lwinmoe51/EchoEarCopyProj/Interface.kicad_sch

## KiCad design Interface.kicad_sch (2026-01-03, an earlier design)

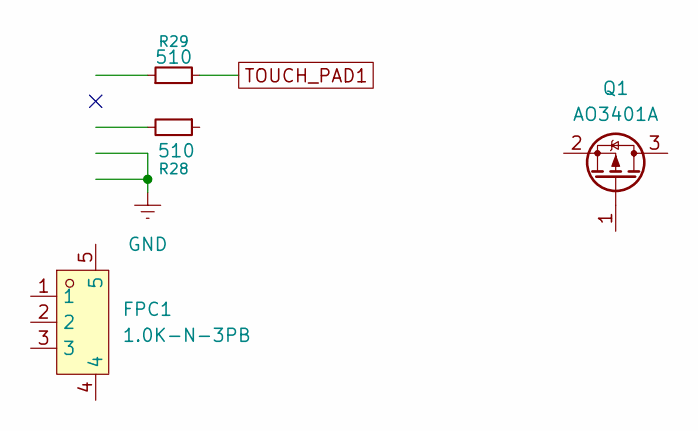
[picture p1: schematic Interface.kicad_sch]

Parts:
FPC1: 1.0K-N-3PB; FPC-SMD_3P-P1.00_HDGC_1.0K-N-3PB; LCSC Part C2915549
Q1: AO3401A; SOT-23
R28, R29: 510

Connections:
TOUCH_PAD1: R29.2
