lwinmoe51/EchoEarCopyProj/MCU.kicad_sch

## KiCad design MCU.kicad_sch (2026-01-03, an earlier design)

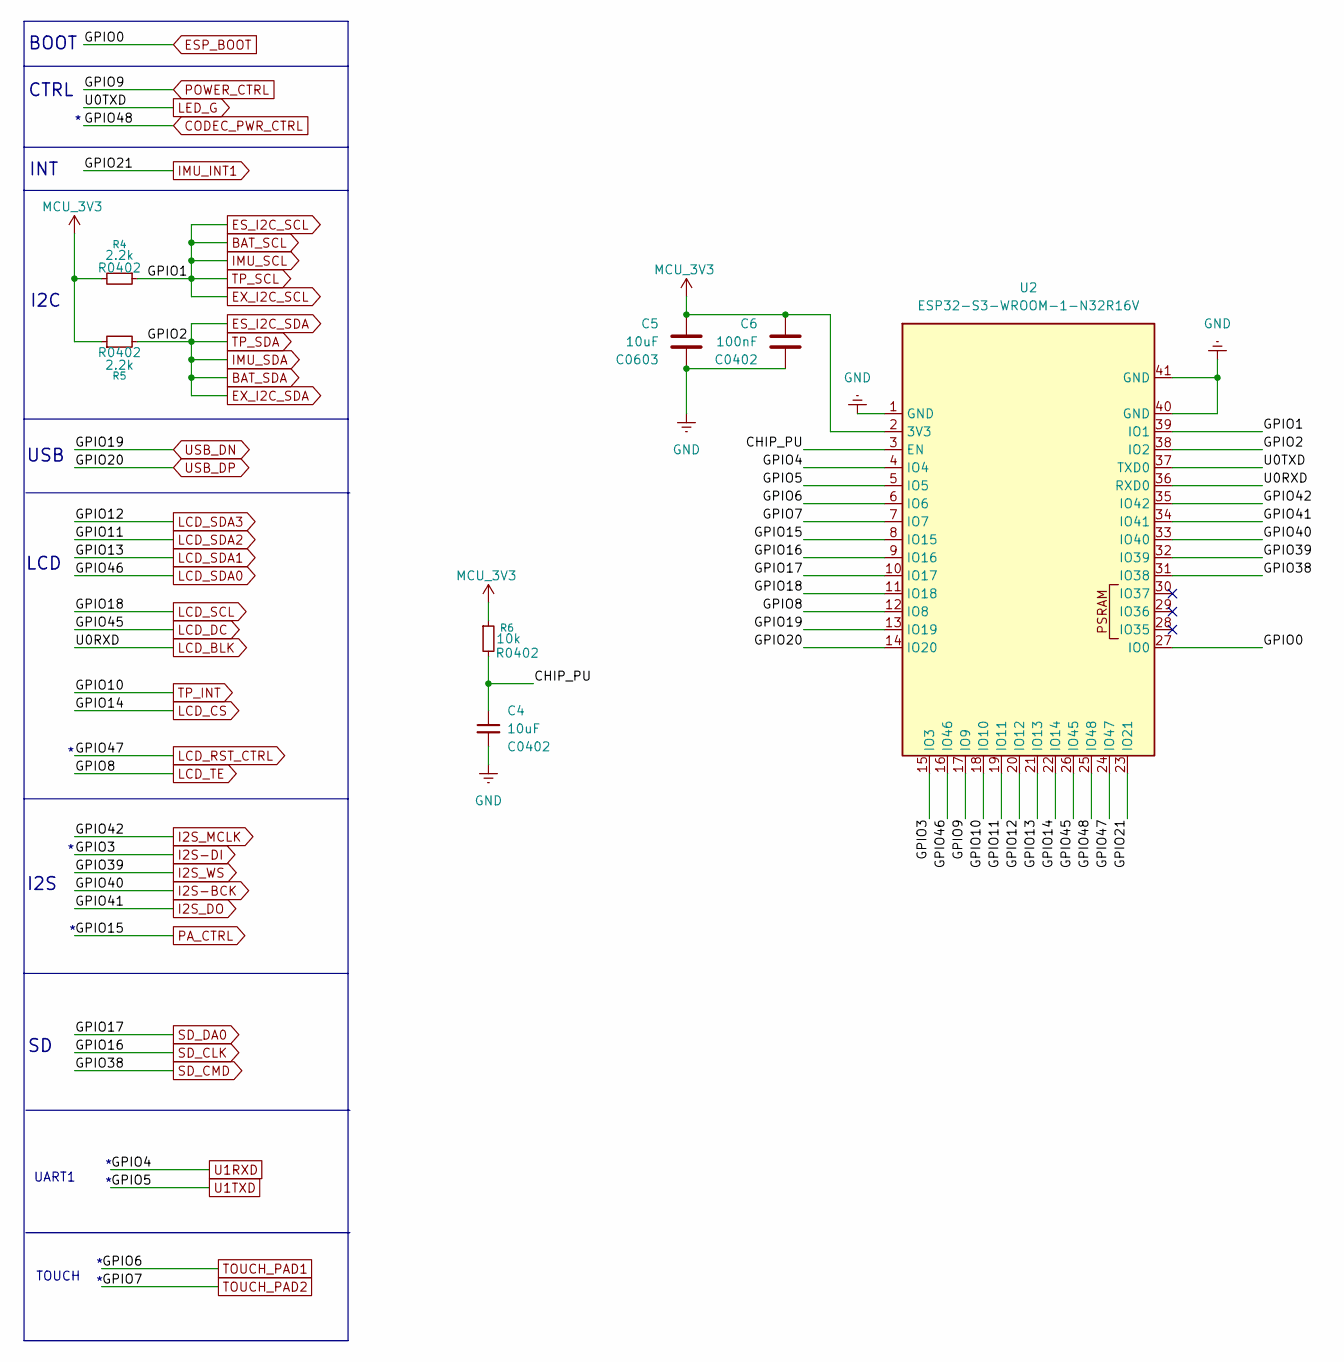
[picture p2: schematic MCU.kicad_sch]

Parts:
C4: 10uF; C0402
C5: 10uF; C0603
C6: 100nF; C0402
R4, R5: 2.2k; R0402
R6: 10k; R0402
U2: ESP32-S3-WROOM-1-N32R16V; ESP32-S3-WROOM-1

Connections:
BAT_SCL: R4.1, U2.39 (IO1)
BAT_SDA: R5.2, U2.38 (IO2)
CHIP_PU: C4.1, R6.2, U2.3 (EN)
CODEC_PWR_CTRL: U2.25 (IO48)
ESP_BOOT: U2.27 (IO0)
GND: C4.2, C5.2, C6.1, U2.1 (GND), U2.40 (GND), U2.41 (GND)
I2S-BCK: U2.33 (IO40)
I2S-DI: U2.15 (IO3)
I2S_DO: U2.34 (IO41)
I2S_MCLK: U2.35 (IO42)
I2S_WS: U2.32 (IO39)
IMU_INT1: U2.23 (IO21)
LCD_BLK: U2.36 (RXD0)
LCD_CS: U2.22 (IO14)
LCD_DC: U2.26 (IO45)
LCD_RST_CTRL: U2.24 (IO47)
LCD_SCL: U2.11 (IO18)
LCD_SDA0: U2.16 (IO46)
LCD_SDA1: U2.21 (IO13)
LCD_SDA2: U2.19 (IO11)
LCD_SDA3: U2.20 (IO12)
LCD_TE: U2.12 (IO8)
LED_G: U2.37 (TXD0)
MCU_3V3: C5.1, C6.2, R4.2, R5.1, R6.1, U2.2 (3V3)
PA_CTRL: U2.8 (IO15)
POWER_CTRL: U2.17 (IO9)
SD_CLK: U2.9 (IO16)
SD_CMD: U2.31 (IO38)
SD_DA0: U2.10 (IO17)
TOUCH_PAD1: U2.6 (IO6)
TOUCH_PAD2: U2.7 (IO7)
TP_INT: U2.18 (IO10)
U1RXD: U2.4 (IO4)
U1TXD: U2.5 (IO5)
USB_DN: U2.13 (IO19)
USB_DP: U2.14 (IO20)

Notes on the sheet:
LCD
CTRL
TOUCH
BOOT
I2S
I2C
UART1
INT
USB
