lwinmoe51/EchoEarCopyProj/P1.kicad_sch

## KiCad design P1.kicad_sch (2026-01-10)

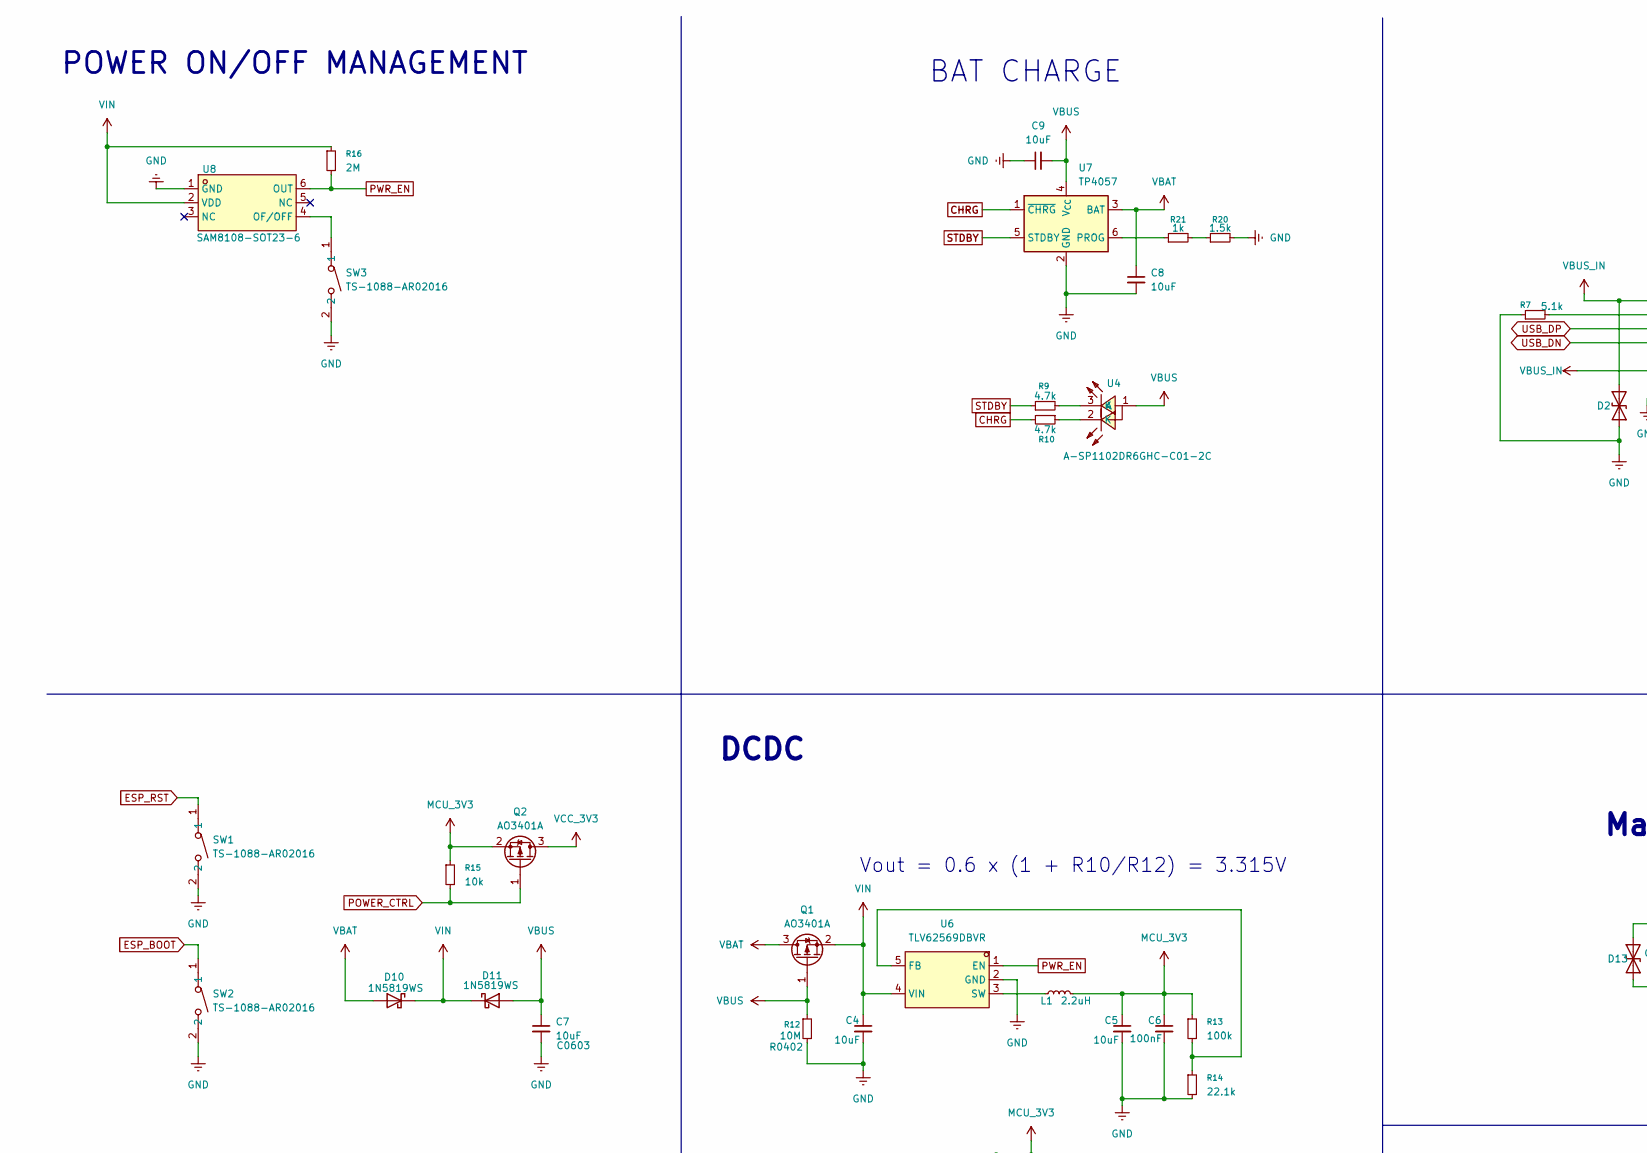
[picture p3: schematic P1.kicad_sch, part in row 1, column 1]

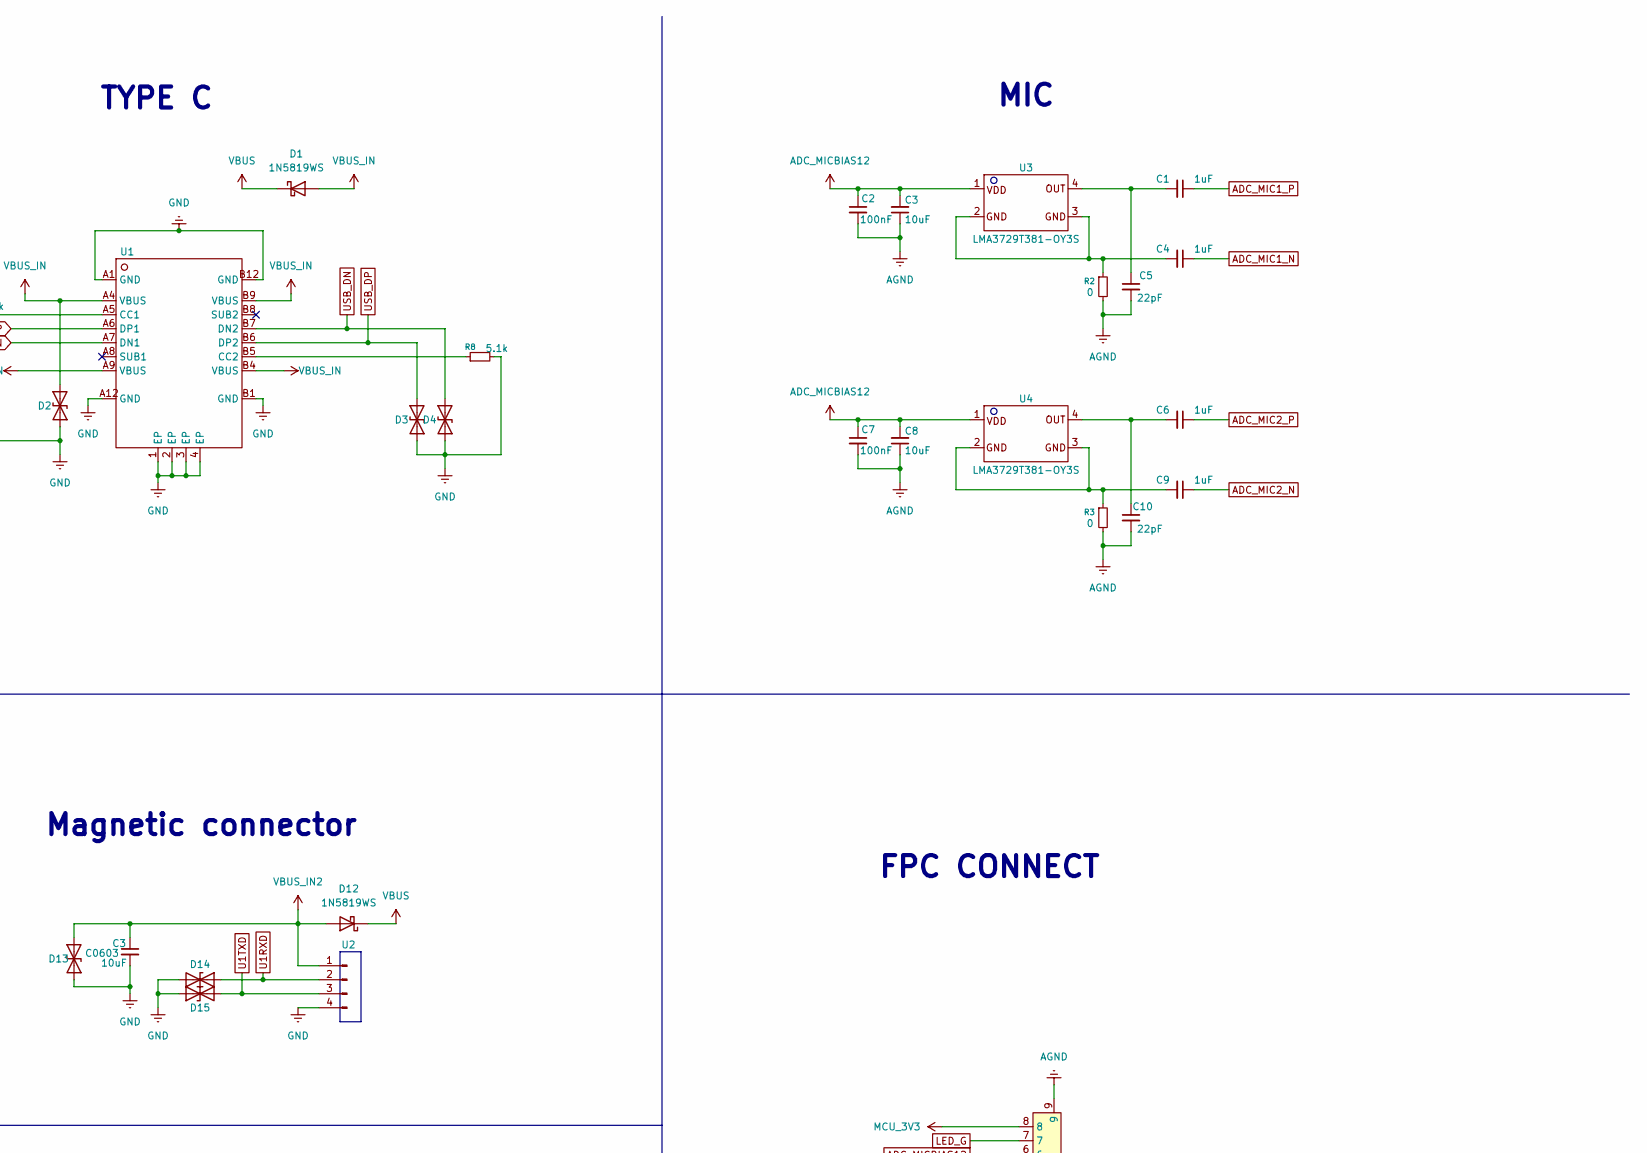
[picture p4: schematic P1.kicad_sch, part in row 1, column 2]

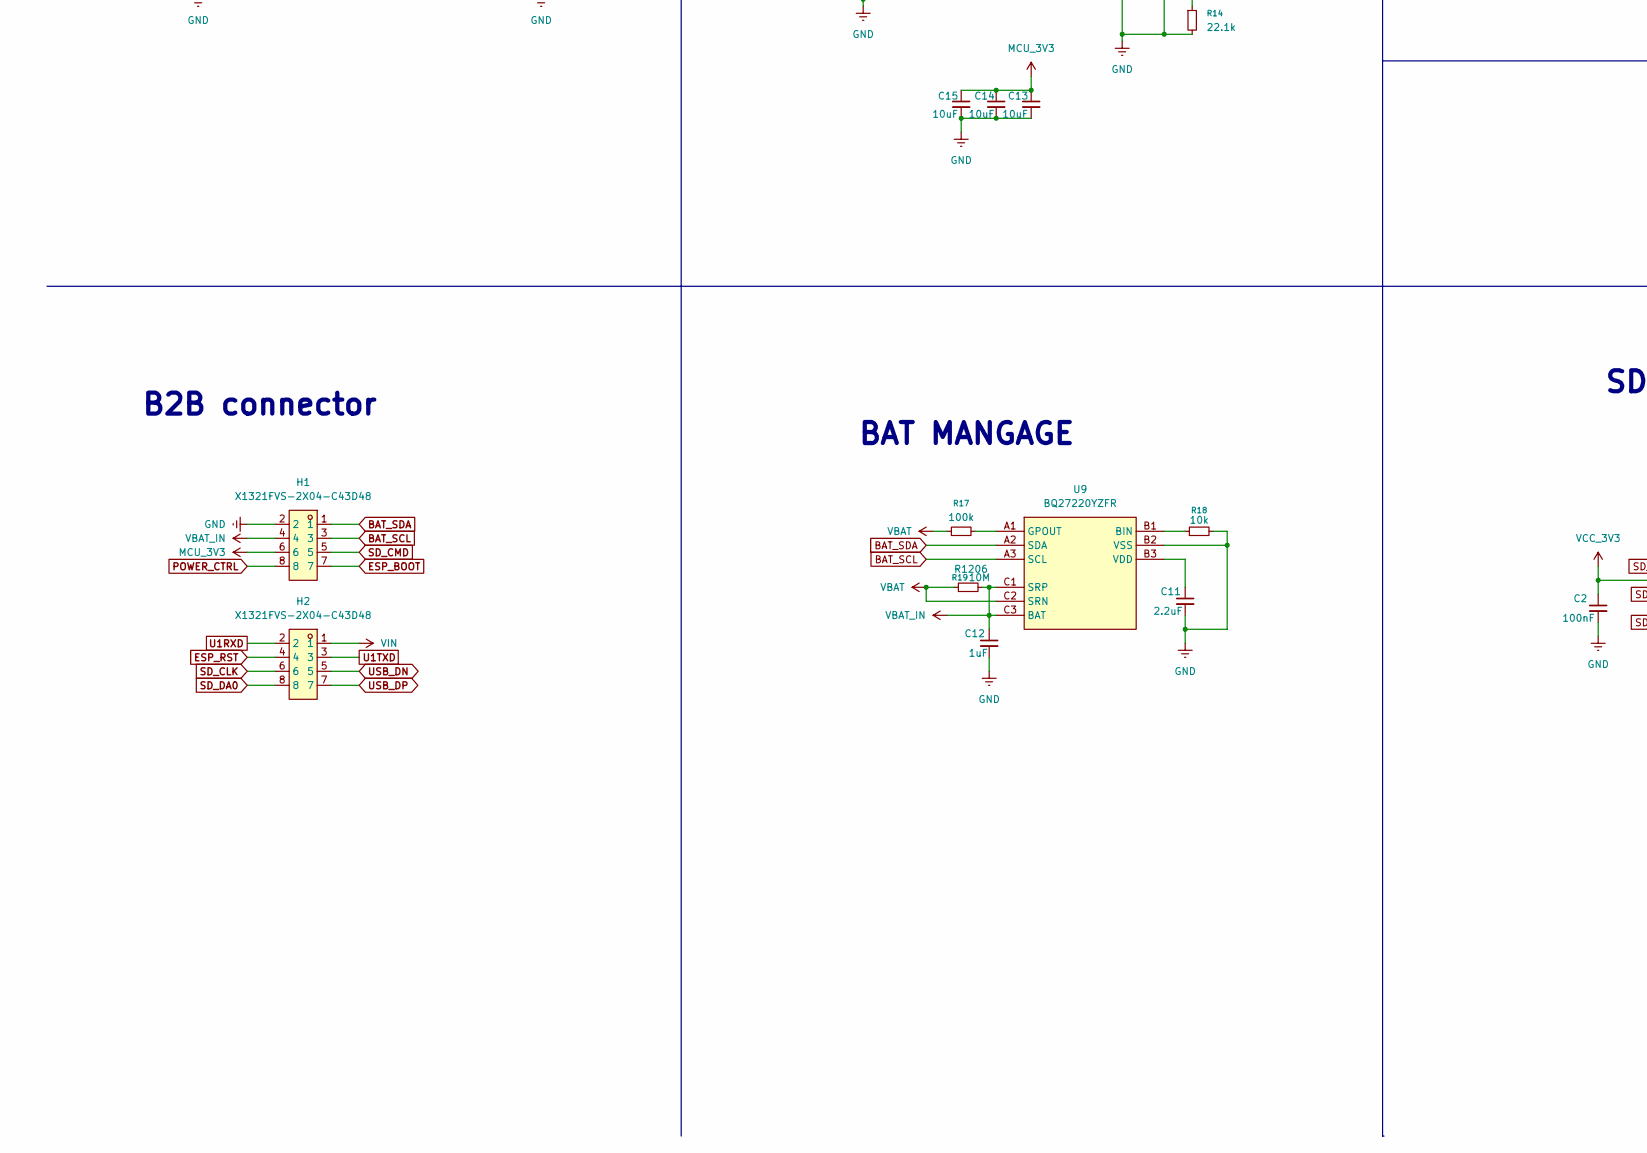
[picture p5: schematic P1.kicad_sch, part in row 2, column 1]

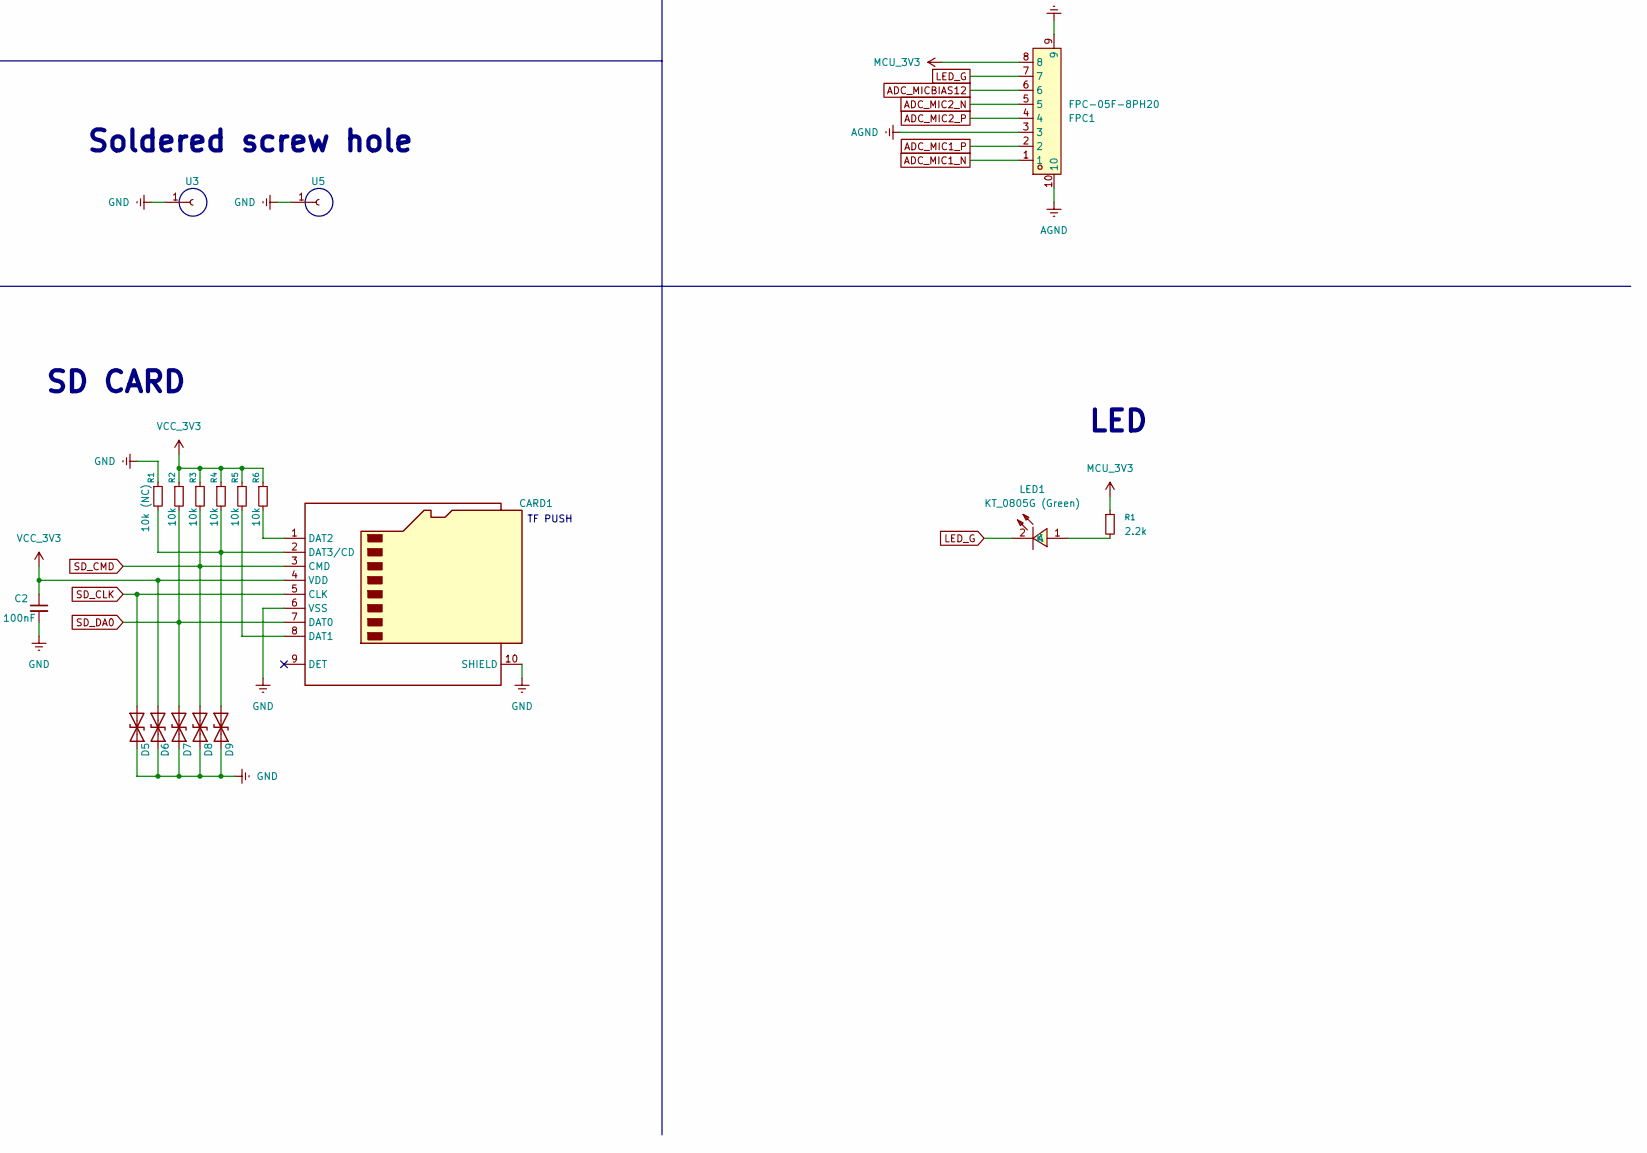
[picture p6: schematic P1.kicad_sch, part in row 2, column 2]

Parts:
C1, C4, C12: 1uF
C2, C6, C7: 100nF
C3: 10uF; C0603
C5, C10: 22pF
C8, C9, C13, C14, C15: 10uF
C11: 2.2uF
CARD1: Micro_SD_Card_Det1
D1, D10, D11, D12: 1N5819WS; D_SOD-323
D2, D3, D4, D5, D6, D7, D8, D9, D13, D14, D15: 1.5KExxCA; D_DO-201AE_P15.24mm_Horizontal
FPC1: FPC-05F-8PH20; FPC-05F-8PH20_FPC-SMD_8P-P0.50_FPC-05F-8PH20; LCSC Part C2856797
H1, H2: X1321FVS-2X04-C43D48; X1321FVS-2x04-C43D48_HDR-SMD_8P-P1.27-V-F-R2-C4-LS4.8; LCSC Part C2684732
L1: 2.2uH
LED1: KT_0805G (Green); KT-0805G_LED0805-R-RD; LCSC Part C2297
Q1, Q2: AO3401A; SOT-23
R1: 10k (NC)
R2, R3, R4, R5, R6, R15, R18: 10k
R7, R8: 5.1k
R9, R10: 4.7k
R12: 10M; R0402
R13, R17: 100k
R14: 22.1k
R16: 2M
R19: 10M; R1206
R20: 1.5k
R21: 1k
SW1, SW2, SW3: TS-1088-AR02016; TS-1088-AR02016_SW-SMD_L3.9-W3.0-P4.45; LCSC Part C720477
U1: (no value)
U2: Conn_01x04_Pin
U3: LMA3729T381-OY3S
U4: A-SP1102DR6GHC-C01-2C; A-SP1102DR6GHC-C01-2C_LED-SMD_3P-L3.0-W1.5_A-SP1102DR6W1D-C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; LCSC Part C19171306
U5: Conn_01x01_Socket
U6: TLV62569DBVR; TLV62569DBVR_SOT-23-5_L3.0-W1.7-P0.95-LS2.8-BR; LCSC Part C141836
U7: TP4057; TSOT-23-6
U8: SAM8108-SOT23-6; SAM8108-SOT-23-6_L2.9-W1.6-P0.95-LS2.8-BL; LCSC Part C9900004427
U9: BQ27220YZFR; DSBGA-9_L1.7-W1.6-R3-C3-P0.50-BL; LCSC Part C528617

Connections:
ADC_MIC1_N: C4.1, FPC1.1
ADC_MIC1_P: C1.1, FPC1.2
ADC_MIC2_N: C9.1, FPC1.5
ADC_MIC2_P: C6.1, FPC1.4
ADC_MICBIAS12: C2.1, C3.2, C7.1, C8.2, FPC1.6, U3.1, U4.1
AGND: C2.2, C3.1, C5.2, C7.2, C8.1, C10.2, FPC1.3, FPC1.9, FPC1.10, R2.2, R3.2
BAT_SCL: H1.3, U9.A3 (SCL)
BAT_SDA: H1.1, U9.A2 (SDA)
CHRG: R10.2, U7.1 (~CHRG)
ESP_BOOT: H1.7, SW2.1
ESP_RST: H2.4, SW1.1
GND: C2.2, C3.2, C4.2, C5.2, C6.2, C7.2, C8.2, C9.1, C11.2, C12.2, C13.2, C14.2, C15.2, CARD1.6 (VSS), CARD1.10 (SHIELD), D2.1 (A1), D3.1 (A1), D4.1 (A1), D5.1 (A1), D6.1 (A1), D7.1 (A1), D8.1 (A1), D9.1 (A1), D13.1 (A1), D14.1 (A1), D15.1 (A1), H1.2, R1.1, R7.1, R8.2, R12.2, R14.2, R18.2, R20.2, SW1.2, SW2.2, SW3.2, U1.1 (EP), U1.2 (EP), U1.3 (EP), U1.4 (EP), U1.A1 (GND), U1.A12 (GND), U1.B1 (GND), U1.B12 (GND), U2.4, U3.1, U5.1, U6.2 (GND), U7.2 (GND), U8.1 (GND), U9.B2 (VSS)
LED_G: FPC1.7, LED1.2 (K)
MCU_3V3: C5.1, C6.1, C13.1, C14.1, C15.1, FPC1.8, H1.6, L1.2, Q2.2 (S), R1.1, R13.1, R15.1
unnamed: C1.2, C5.1, U3.4
unnamed: C4.2, R2.1, U3.2, U3.3
unnamed: C9.2, R3.1, U4.2, U4.3
unnamed: C6.2, C10.1, U4.4
unnamed: C11.1, U9.B3 (VDD)
unnamed: CARD1.1 (DAT2), R6.2
unnamed: CARD1.2 (DAT3/CD), D9.2 (A2), R1.2, R4.2
unnamed: CARD1.8 (DAT1), R5.2
unnamed: L1.1, U6.3 (SW)
unnamed: LED1.1 (A), R1.2
unnamed: R7.2, U1.A5 (CC1)
unnamed: R8.1, U1.B5 (CC2)
unnamed: R9.2, U4.3
unnamed: R10.1, U4.2
unnamed: R13.2, R14.1, U6.5 (FB)
unnamed: R17.2, U9.A1 (GPOUT)
unnamed: R18.1, U9.B1 (BIN)
unnamed: R20.1, R21.2
unnamed: R21.1, U7.6 (PROG)
unnamed: SW3.1, U8.4 (OF/OFF)
POWER_CTRL: H1.8, Q2.1 (G), R15.2
PWR_EN: R16.2, U6.1 (EN), U8.6 (OUT)
SD_CLK: CARD1.5 (CLK), D5.2 (A2), H2.6
SD_CMD: CARD1.3 (CMD), D8.2 (A2), H1.5, R3.2
SD_DA0: CARD1.7 (DAT0), D7.2 (A2), H2.8, R2.2
STDBY: R9.1, U7.5 (STDBY)
U1RXD: D14.2 (A2), H2.2, U2.2
U1TXD: D15.2 (A2), H2.3, U2.3
USB_DN: D4.2 (A2), H2.5, U1.A7 (DN1), U1.B7 (DN2)
USB_DP: D3.2 (A2), H2.7, U1.A6 (DP1), U1.B6 (DP2)
VBAT: C8.1, D10.2 (A), Q1.3 (D), R17.1, R19.1, U7.3 (BAT), U9.C2 (SRN)
VBAT_IN: C12.1, H1.4, R19.2, U9.C1 (SRP), U9.C3 (BAT)
VBUS: C7.1, C9.2, D1.1 (K), D11.2 (A), D12.1 (K), Q1.1 (G), R12.1, U4.1, U7.4 (V_{CC})
VBUS_IN: D1.2 (A), D2.2 (A2), U1.A4 (VBUS), U1.A9 (VBUS), U1.B4 (VBUS), U1.B9 (VBUS)
VBUS_IN2: C3.1, D12.2 (A), D13.2 (A2), U2.1
VCC_3V3: C2.1, CARD1.4 (VDD), D6.2 (A2), Q2.3 (D), R2.1, R3.1, R4.1, R5.1, R6.1
VIN: C4.1, D10.1 (K), D11.1 (K), H2.1, Q1.2 (S), R16.1, U6.4 (VIN), U8.2 (VDD)

Notes on the sheet:
B2B connector
TYPE C
MIC
SD CARD
DCDC
Soldered screw hole
BAT MANGAGE
Vout = 0.6 x (1 + R10/R12) = 3.315V
TF PUSH
POWER ON/OFF MANAGEMENT
BAT CHARGE
LED
FPC CONNECT
Magnetic connector
