lwinmoe51/EchoEarCopyProj/codec.kicad_sch

## KiCad design codec.kicad_sch (2026-01-08)

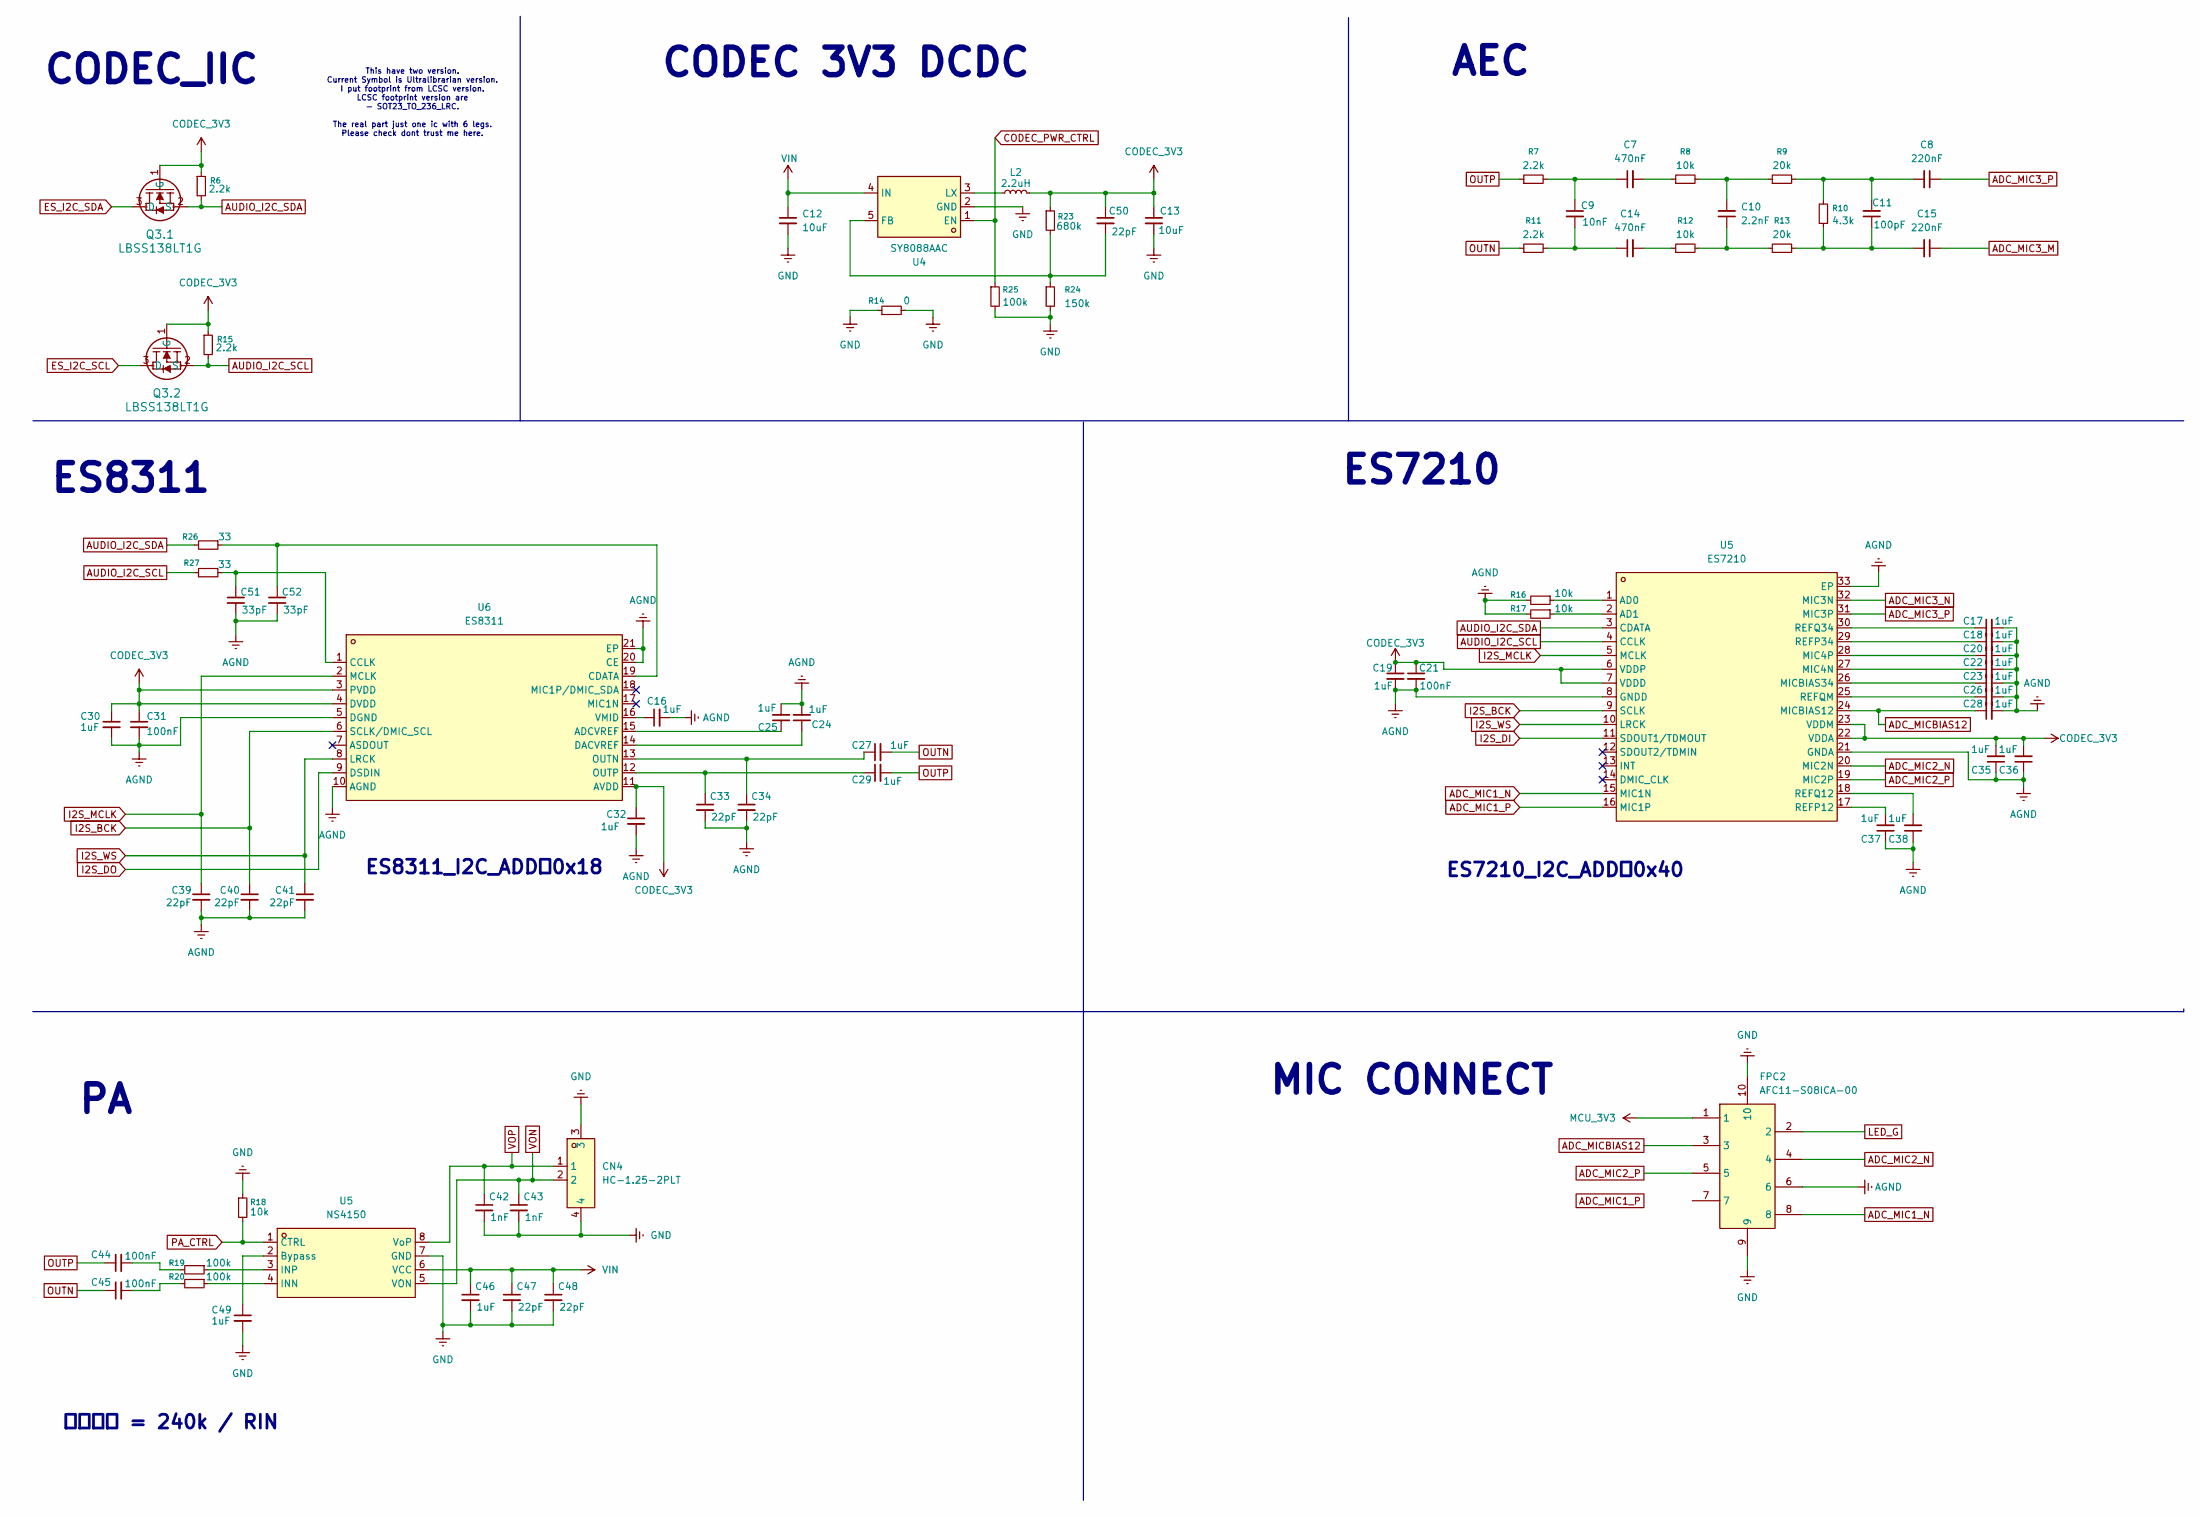
[picture p7: schematic codec.kicad_sch]

Parts:
C7, C14: 470nF
C8, C15: 220nF
C9: 10nF
C10: 2.2nF
C11: 100pF
C12, C13: 10uF
C16, C17, C18, C19, C20, C22, C23, C24, C25, C26, C27, C28, C29, C30, C32, C35, C36, C37, C38, C46, C49: 1uF
C21, C31, C44, C45: 100nF
C33, C34, C39, C40, C41, C47, C48, C50: 22pF
C42, C43: 1nF
C51, C52: 33pF
CN4: HC-1.25-2PLT; CONN-SMD_4P-P1.25_HCTL_HC-1.25-4PLT; LCSC Part C2845388
FPC2: AFC11-S08ICA-00; CONN-TH-8P_AFC11-S08ICA-00; LCSC Part C262497
L2: 2.2uH
Q3.1, Q3.2: LBSS138LT1G; LBSS138LT1G_SC-88-6_L2.0-W1.3-P0.65-LS2.1-BL
R6, R7, R11, R15: 2.2k
R8, R12, R16, R17, R18: 10k
R9, R13: 20k
R10: 4.3k
R14: 0
R19, R20, R25: 100k
R23: 680k
R24: 150k
R26, R27: 33
U4: SY8088AAC; SY8088AAC_SOT-23-5_L3.0-W1.7-P0.95-LS2.8-BR; LCSC Part C79313
U5: ES7210; ES7210_QFN-32_L4.0-W4.0-P0.40-BL-EP2.7; LCSC Part C365743
U6: ES8311; ES8311_WQFN-20_L3.0-W3.0-P0.40-BL-EP1.7; LCSC Part C962342

Connections:
ADC_MIC1_N: FPC2.8, U5.15 (MIC1N)
ADC_MIC1_P: U5.16 (MIC1P)
ADC_MIC2_N: FPC2.4, U5.20 (MIC2N)
ADC_MIC2_P: FPC2.5, U5.19 (MIC2P)
ADC_MIC3_M: C15.1
ADC_MIC3_N: U5.32 (MIC3N)
ADC_MIC3_P: C8.1, U5.31 (MIC3P)
ADC_MICBIAS12: C28.1, FPC2.3, U5.24 (MICBIAS12)
AGND: C16.2, C17.2, C18.2, C19.2, C20.2, C21.2, C22.2, C23.2, C24.2, C25.2, C26.2, C28.2, C30.2, C31.2, C32.2, C33.2, C34.2, C35.1, C36.1, C37.1, C38.1, C39.2, C40.2, C41.2, C51.2, C52.2, FPC2.6, R16.2, R17.2, U5.8 (VoP), U5.21 (GNDA), U5.33 (EP), U6.5 (DGND), U6.10 (AGND), U6.20 (CE), U6.21 (EP)
AUDIO_I2C_SCL: Q3.2.2 (S), R15.2, R27.1, U5.4 (INN)
AUDIO_I2C_SDA: Q3.1.2 (S), R6.2, R26.2, U5.3 (INP)
CODEC_3V3: C13.1, C19.1, C21.1, C30.1, C31.1, C32.1, C35.2, C36.2, C50.1, L2.2, Q3.1.1 (G), Q3.2.1 (G), R6.1, R15.1, R23.1, U5.6 (VCC), U5.7 (GND), U5.22 (VDDA), U5.23 (VDDM), U6.3 (PVDD), U6.4 (DVDD), U6.11 (AVDD)
CODEC_PWR_CTRL: R25.1, U4.1 (EN)
ES_I2C_SCL: Q3.2.3 (D)
ES_I2C_SDA: Q3.1.3 (D)
GND: C12.2, C13.2, C42.2, C43.2, C46.2, C47.2, C48.2, C49.2, CN4.3, CN4.4, FPC2.9, FPC2.10, R14.1, R14.2, R18.1, R24.2, R25.2, U4.2 (GND), U5.7 (GND)
I2S_BCK: C40.1, U5.9 (SCLK), U6.6 (SCLK/DMIC_SCL)
I2S_DI: U5.11 (SDOUT1/TDMOUT)
I2S_DO: U6.9 (DSDIN)
I2S_MCLK: C39.1, U5.5 (VON), U6.2 (MCLK)
I2S_WS: C41.1, U5.10 (LRCK), U6.8 (LRCK)
LED_G: FPC2.2
MCU_3V3: FPC2.1
unnamed: C7.1, C9.1, R7.2
unnamed: C7.2, R8.1
unnamed: C10.1, R12.2, R13.1
unnamed: C10.2, R8.2, R9.1
unnamed: C11.1, C15.2, R10.1, R13.2
unnamed: C8.2, C11.2, R9.2, R10.2
unnamed: C9.2, C14.1, R11.2
unnamed: C14.2, R12.1
unnamed: C16.1, U6.16 (VMID)
unnamed: C17.1, U5.30 (REFQ34)
unnamed: C18.1, U5.29 (REFP34)
unnamed: C20.1, U5.28 (MIC4P)
unnamed: C22.1, U5.27 (MIC4N)
unnamed: C23.1, U5.26 (MICBIAS34)
unnamed: C24.1, U6.14 (DACVREF)
unnamed: C25.1, U6.15 (ADCVREF)
unnamed: C26.1, U5.25 (REFQM)
unnamed: C27.1, C34.1, U6.13 (OUTN)
unnamed: C29.1, C33.1, U6.12 (OUTP)
unnamed: C37.2, U5.17 (REFP12)
unnamed: C38.2, U5.18 (REFQ12)
unnamed: C44.2, R19.2
unnamed: C45.2, R20.2
unnamed: C49.1, U5.2 (Bypass)
unnamed: C50.2, R23.2, R24.1, U4.5 (FB)
unnamed: C51.1, R27.2, U6.1 (CCLK)
unnamed: C52.1, R26.1, U6.19 (CDATA)
unnamed: L2.1, U4.3 (LX)
unnamed: R16.1, U5.1 (CTRL)
unnamed: R17.1, U5.2 (Bypass)
unnamed: R19.1, U5.3 (INP)
unnamed: R20.1, U5.4 (INN)
OUTN: C27.2, C45.1, R11.1
OUTP: C29.2, C44.1, R7.1
PA_CTRL: R18.2, U5.1 (CTRL)
VIN: C12.1, C46.1, C47.1, C48.1, U4.4 (IN), U5.6 (VCC)
VON: C43.1, CN4.2, U5.5 (VON)
VOP: C42.1, CN4.1, U5.8 (VoP)

Notes on the sheet:
CODEC_IIC
放大倍数 = 240k / RIN
ES8311
ES7210
MIC CONNECT
CODEC 3V3 DCDC
This have two version. Current Symbol is Ultralibrarian version. I put footprint from LCSC version. LCSC footprint version are - SOT23_TO_236_LRC. The real part just one ic with 6 legs. Please check dont trust me here.
ES7210_I2C_ADD：0x40
AEC
ES8311_I2C_ADD：0x18
