lwinmoe51/EchoEarCopyProj/(commit log)

2025-12-29 1st page done
    [EchoEarCopyProj.kicad_pcb, EchoEarCopyProj.kicad_sch]
2026-01-03 before file cleaning 3.1.2026
    [EchoEarCopyProj.kicad_pcb, EchoEarCopyProj.kicad_sch, Interface.kicad_sch, MCU.kicad_sch, untitled.kicad_sch]
2026-01-03 done interfacePage
    [Interface.kicad_sch, MCU.kicad_sch, untitled.kicad_sch]
2026-01-08 done CodecPage
    [codec.kicad_sch]
2026-01-10 done schematic without all footprints
    [EchoEarCopyProj.kicad_sch, P1.kicad_sch]
